stephendpmurphy/usb-dev-hardware/usb-dev/models/LPC55S16JEV98E/VFBGA98_SOT1982-1_NXP.step

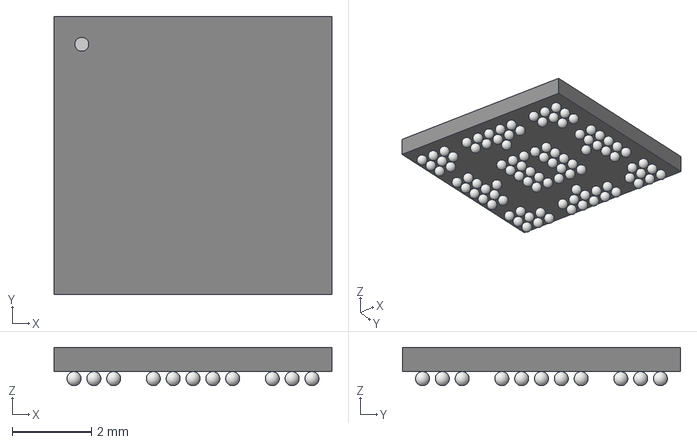
[picture p1: CAD file, 2022-01-26]
usb-dev/models/LPC55S16JEV98E/VFBGA98_SOT1982-1_NXP.step
7.01 x 7.01 x 0.968 mm
