stephendpmurphy/usb-dev-hardware/usb-dev/models/TL1014BF160QG/TL1014BFxxxQG.stp

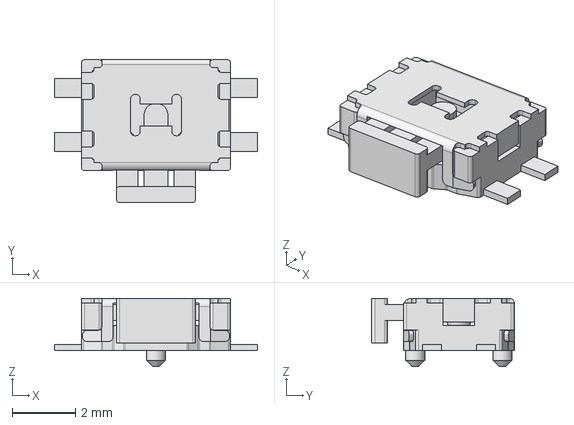
[picture p2: CAD file, 2022-01-26]
usb-dev/models/TL1014BF160QG/TL1014BFxxxQG.stp
6.40 x 4.50 x 2.15 mm
