stephendpmurphy/usb-dev-hardware/usb-dev/models/104031-0811/1040310811.stp

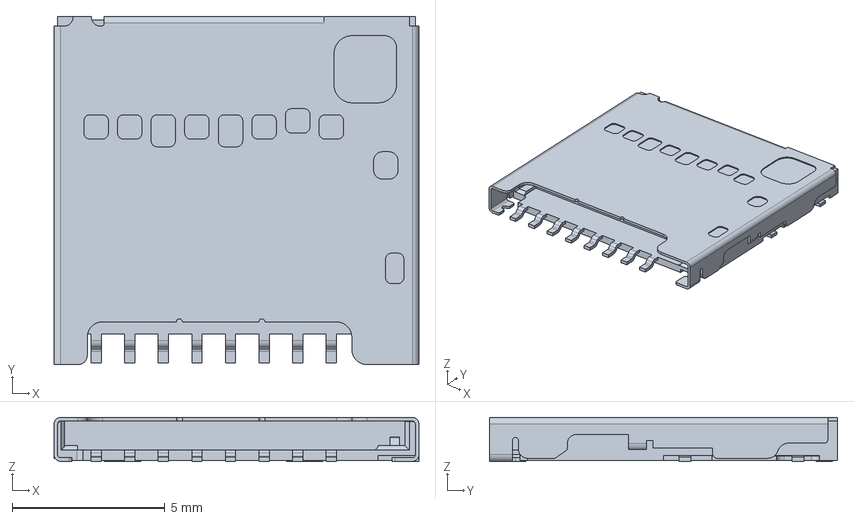
[picture p3: CAD file, 2022-01-26]
usb-dev/models/104031-0811/1040310811.stp
12.0 x 11.4 x 1.45 mm
