stephendpmurphy/usb-dev-hardware/usb-dev/usb-dev.kicad_pcb

## KiCad design usb-dev/usb-dev.kicad_pcb (2022-03-21)

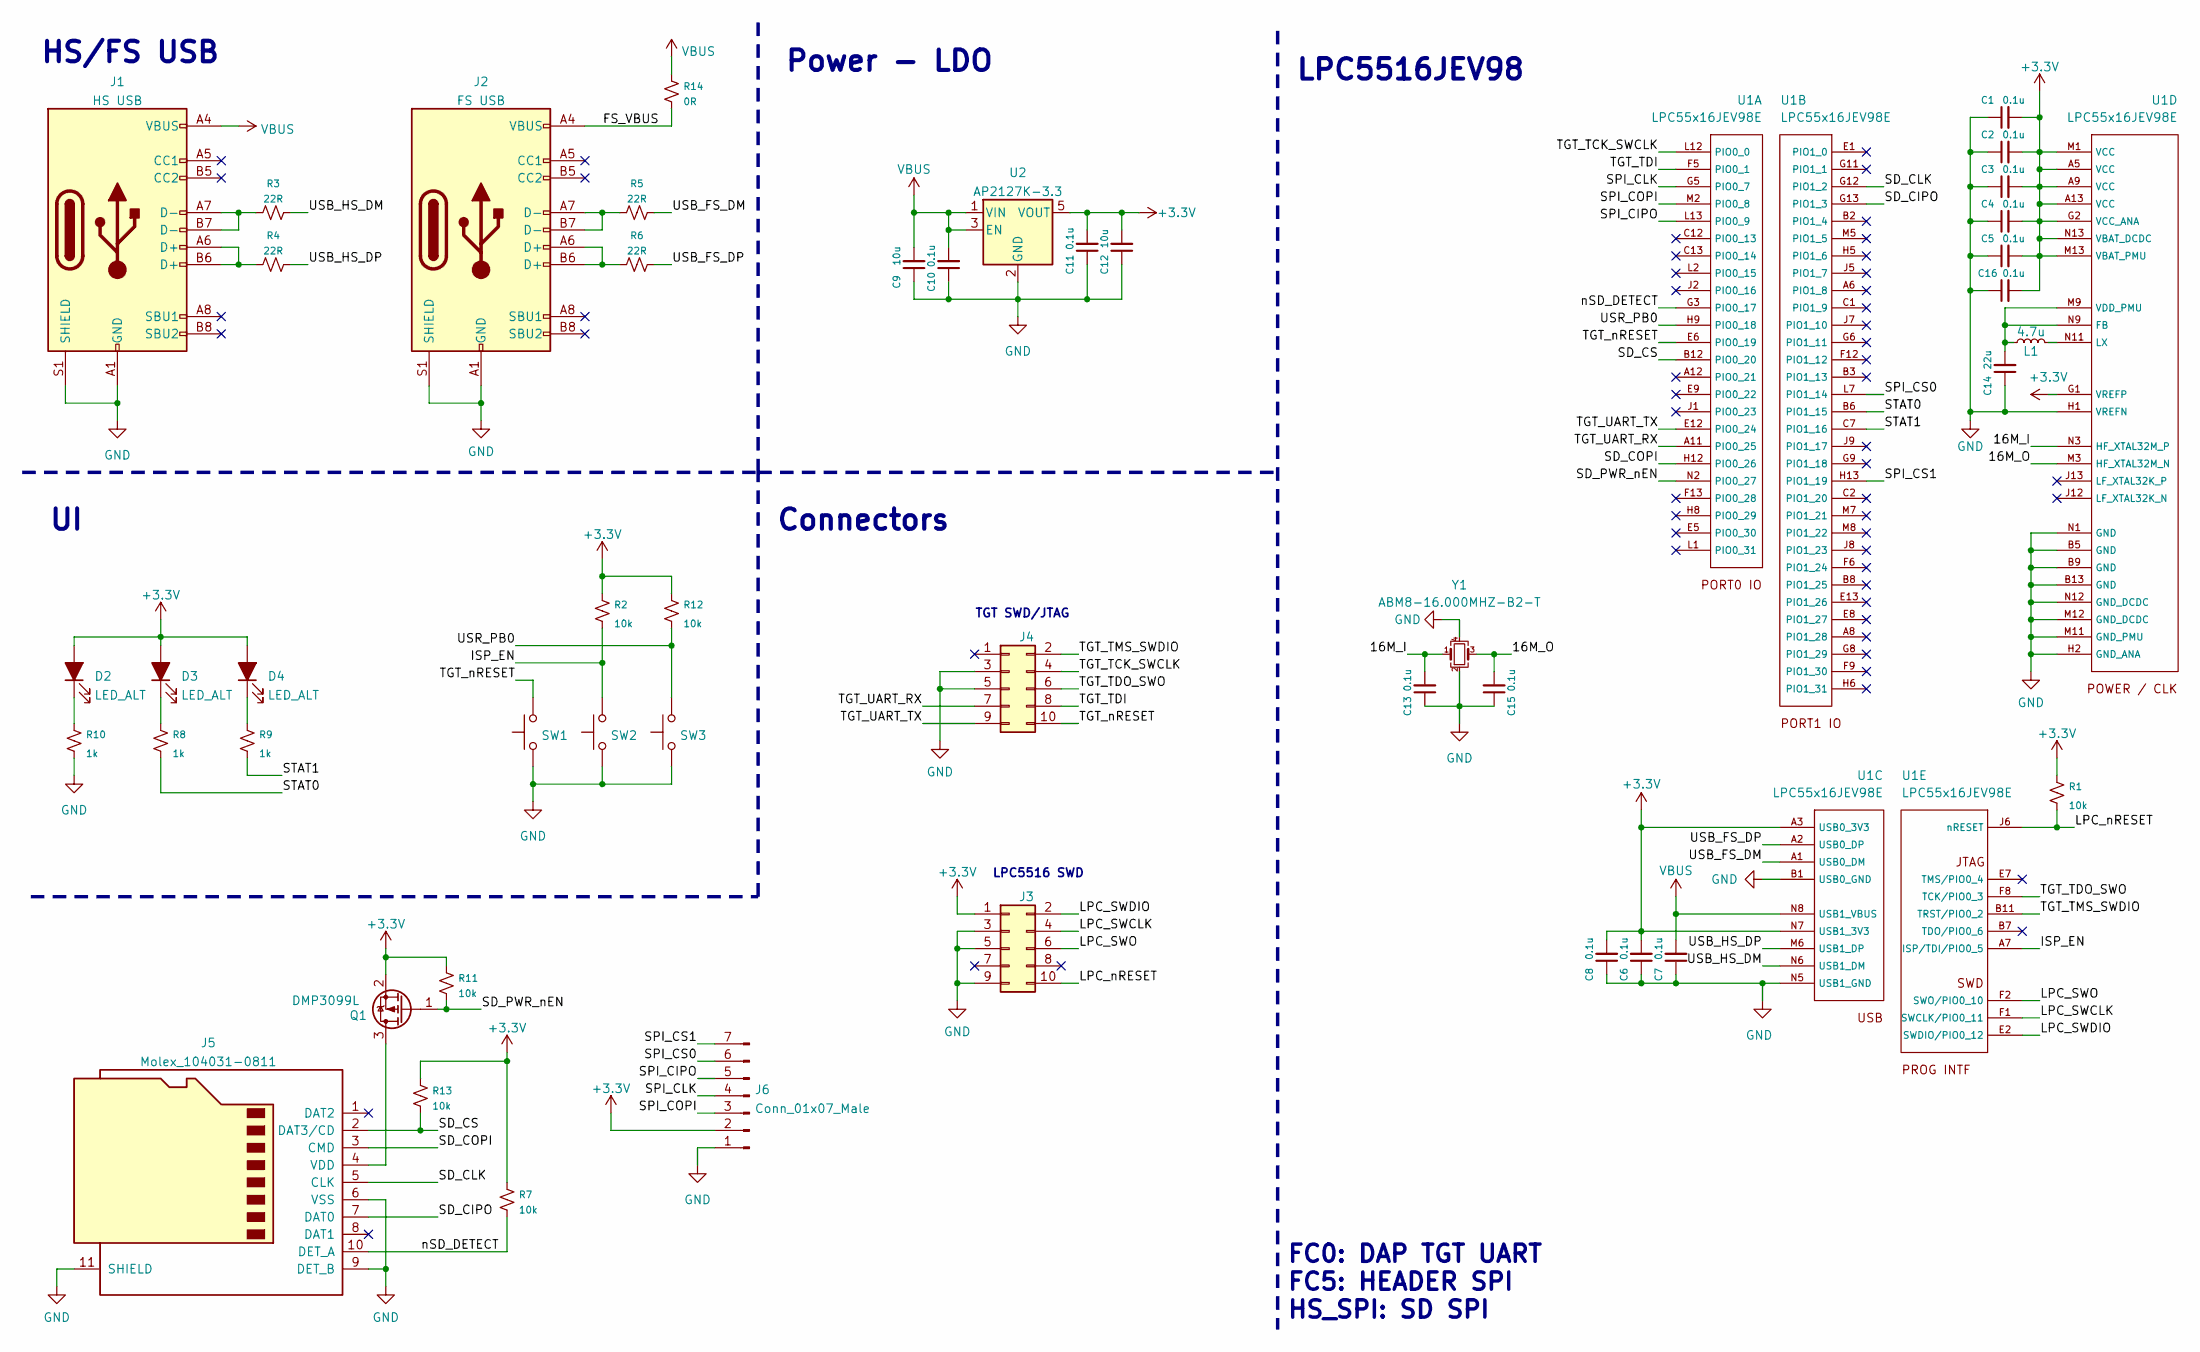
[picture p4: schematic usb-dev.kicad_sch]

Parts:
C1, C2, C3, C4, C5, C6, C7, C8, C10, C11, C13, C15, C16: 0.1u; C_0402_1005Metric
C9, C12: 10u; C_0402_1005Metric
C14: 22u; C_0402_1005Metric
D2, D3, D4: LED_ALT; LED_0402_1005Metric
J1: HS USB; USB_C_Receptacle_GCT_USB4085
J2: FS USB; USB_C_Receptacle_GCT_USB4085
J3, J4: Conn_02x05_Odd_Even; PinHeader_2x05_P1.27mm_Vertical_SMD
J5: Molex_104031-0811; microSD_HC_Molex_104031-0811
J6: Conn_01x07_Male; PinHeader_1x07_P2.54mm_Vertical
L1: 4.7u; L_0805_2012Metric
Q1: DMP3099L; SOT-23
R1, R2, R7, R11, R12, R13: 10k; R_0402_1005Metric
R3, R4, R5, R6: 22R; R_0402_1005Metric
R8, R9, R10: 1k; R_0402_1005Metric
R14: 0R; R_0402_1005Metric
SW1, SW2, SW3: SW_Push; Panasonic_EVQPUJ_EVQPUA
U1: LPC55x16JEV98E; BGA-98_13x13_7.0x7.0mm
U2: AP2127K-3.3; SOT-23-5
Y1: ABM8-16.000MHZ-B2-T; Crystal_SMD_3225-4Pin_3.2x2.5mm

Connections:
+3V3: C1.2, C2.2, C3.2, C4.2, C5.2, C6.2, C8.2, C11.2, C12.2, C16.2, D2.2 (A), D3.2 (A), D4.2 (A), J3.1, J6.2, Q1.2 (S), R1.1, R2.1, R7.2, R11.2, R12.1, R13.2, U1.A3 (USB0_3V3), U1.A5 (VCC), U1.A9 (VCC), U1.A13 (VCC), U1.G1 (VREFP), U1.G2 (VCC_ANA), U1.M1 (VCC), U1.M13 (VBAT_PMU), U1.N7 (USB1_3V3), U1.N13 (VBAT_DCDC), U2.5 (VOUT)
/16M_I: C13.2, U1.N3 (HF_XTAL32M_P), Y1.1
/16M_O: C15.2, U1.M3 (HF_XTAL32M_N), Y1.3
/FS_VBUS: J2.A4 (VBUS), J2.A9 (VBUS), J2.B4 (VBUS), J2.B9 (VBUS), R14.1
/ISP_EN: R2.2, SW2.2, U1.A7 (ISP/TDI/PIO0_5)
/LPC_SWCLK: J3.4, U1.F1 (SWCLK/PIO0_11)
/LPC_SWDIO: J3.2, U1.E2 (SWDIO/PIO0_12)
/LPC_SWO: J3.6, U1.F2 (SWO/PIO0_10)
/LPC_nRESET: J3.10, R1.2, U1.J6 (nRESET)
/SD_CIPO: J5.7 (DAT0), U1.G13 (PIO1_3)
/SD_CLK: J5.5 (CLK), U1.G12 (PIO1_2)
/SD_COPI: J5.3 (CMD), U1.H12 (PIO0_26)
/SD_CS: J5.2 (DAT3/CD), R13.1, U1.B12 (PIO0_20)
/SD_PWR_nEN: Q1.1 (G), R11.1, U1.N2 (PIO0_27)
/SPI_CIPO: J6.5, U1.L13 (PIO0_9)
/SPI_CLK: J6.4, U1.G5 (PIO0_7)
/SPI_COPI: J6.3, U1.M2 (PIO0_8)
/SPI_CS0: J6.6, U1.L7 (PIO1_14)
/SPI_CS1: J6.7, U1.H13 (PIO1_19)
/STAT0: R8.2, U1.B6 (PIO1_15)
/STAT1: R9.2, U1.C7 (PIO1_16)
/TGT_TCK_SWCLK: J4.4, U1.L12 (PIO0_0)
/TGT_TDI: J4.8, U1.F5 (PIO0_1)
/TGT_TDO_SWO: J4.6, U1.F8 (TCK/PIO0_3)
/TGT_TMS_SWDIO: J4.2, U1.B11 (TRST/PIO0_2)
/TGT_UART_RX: J4.7, U1.A11 (PIO0_25)
/TGT_UART_TX: J4.9, U1.E12 (PIO0_24)
/TGT_nRESET: J4.10, SW1.2, U1.E6 (PIO0_19)
/USB_FS_DM: R5.2, U1.A1 (USB0_DM)
/USB_FS_DP: R6.2, U1.A2 (USB0_DP)
/USB_HS_DM: R3.2, U1.N6 (USB1_DM)
/USB_HS_DP: R4.2, U1.M6 (USB1_DP)
/USR_PB0: R12.2, SW3.2, U1.H9 (PIO0_18)
/nSD_DETECT: J5.10 (DET_A), R7.1, U1.G3 (PIO0_17)
GND: C1.1, C2.1, C3.1, C4.1, C5.1, C6.1, C7.1, C8.1, C9.1, C10.1, C11.1, C12.1, C13.1, C14.1, C15.1, C16.1, J1.A1 (GND), J1.A12 (GND), J1.B1 (GND), J1.B12 (GND), J1.S1 (SHIELD), J2.A1 (GND), J2.A12 (GND), J2.B1 (GND), J2.B12 (GND), J2.S1 (SHIELD), J3.3, J3.5, J3.9, J4.3, J4.5, J5.6 (VSS), J5.9 (DET_B), J5.11 (SHIELD), J6.1, R10.2, SW1.1, SW2.1, SW3.1, U1.B1 (USB0_GND), U1.B5 (GND), U1.B9 (GND), U1.B13 (GND), U1.H1 (VREFN), U1.H2 (GND_ANA), U1.M11 (GND_PMU), U1.M12 (GND_DCDC), U1.N1 (GND), U1.N5 (USB1_GND), U1.N12 (GND_DCDC), U2.2 (GND), Y1.2, Y1.4
unnamed: C14.2, L1.1, U1.M9 (VDD_PMU), U1.N9 (FB)
unnamed: D2.1 (K), R10.1
unnamed: D3.1 (K), R8.1
unnamed: D4.1 (K), R9.1
unnamed: J1.A6 (D+), J1.B6 (D+), R4.1
unnamed: J1.A7 (D-), J1.B7 (D-), R3.1
unnamed: J2.A6 (D+), J2.B6 (D+), R6.1
unnamed: J2.A7 (D-), J2.B7 (D-), R5.1
unnamed: J5.4 (VDD), Q1.3 (D)
unnamed: L1.2, U1.N11 (LX)
VBUS: C7.2, C9.2, C10.2, J1.A4 (VBUS), J1.A9 (VBUS), J1.B4 (VBUS), J1.B9 (VBUS), R14.2, U1.N8 (USB1_VBUS), U2.1 (VIN), U2.3 (EN)

Notes on the sheet:
Connectors
HS/FS USB
FC0: DAP TGT UART FC5: HEADER SPI HS_SPI: SD SPI
Power - LDO
TGT SWD/JTAG
LPC5516 SWD
LPC5516JEV98

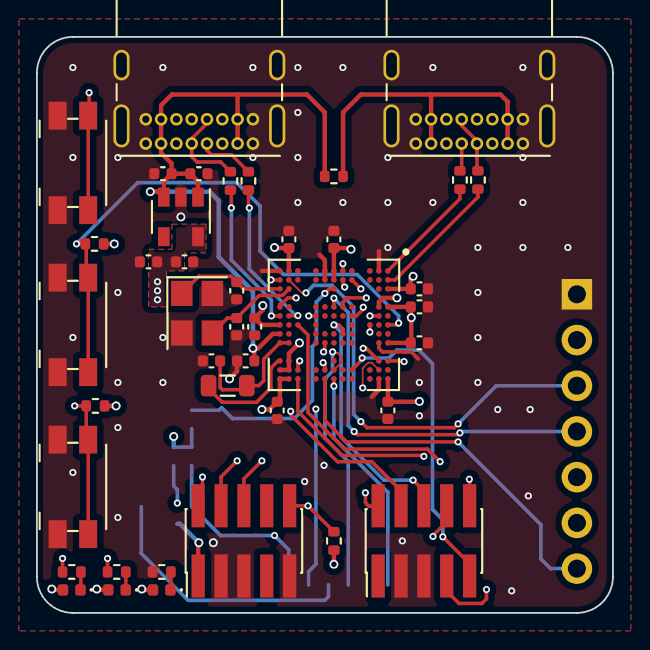
[picture p5: board usb-dev.kicad_pcb from above]

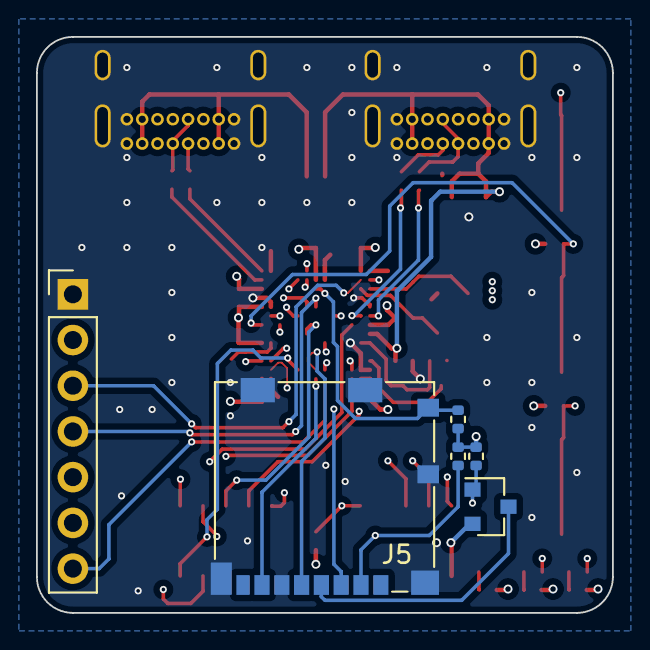
[picture p6: board usb-dev.kicad_pcb from below]

Board: 4 copper layers, 32.0 x 32.0 mm, 47 parts (6 on the bottom side), 46 nets.
