stephendpmurphy/usb-dev-hardware/(commit log)

2022-01-26 Initial commit - Clean ERC and DRC
    [1040310811.stp, TL1014BFxxxQG.stp, VFBGA98_SOT1982-1_NXP.step, usb-dev.kicad_pcb, usb-dev.kicad_sch]
2022-01-28 Clean ERC & DRC - Submitted to PCBWay
    [usb-dev.kicad_pcb, usb-dev.kicad_sch]
2022-02-06 Updating LPC BGA pad size to allow adequate space for soldermask in between pads
    [usb-dev.kicad_pcb]
2022-02-21 Fixed VDD_PMU, added fet to SD power and added extra CS line to SPI header
    [usb-dev.kicad_pcb, usb-dev.kicad_sch]
2022-03-21 Fixed missing VDDCORE connections to internal switcher D:
    [usb-dev.kicad_pcb, usb-dev.kicad_sch]
