stephendpmurphy/usb-dev-hardware/(notices)

Notices in the files:
usb-dev/models/104031-0811/1040310811.stp:
FILE_NAME( 'C:/Users/KMIROS~1/AppData/Local/Temp/psolqas_10224_38.stp', '2020-05-05T20:44:13', ( 'License CC BY-ND 4.0' ), ( 'CADENAS' ), ' ', 'PARTsolutions', ' ' );
